z4yx/StepperMotorTester/PCB/stepper.pdf

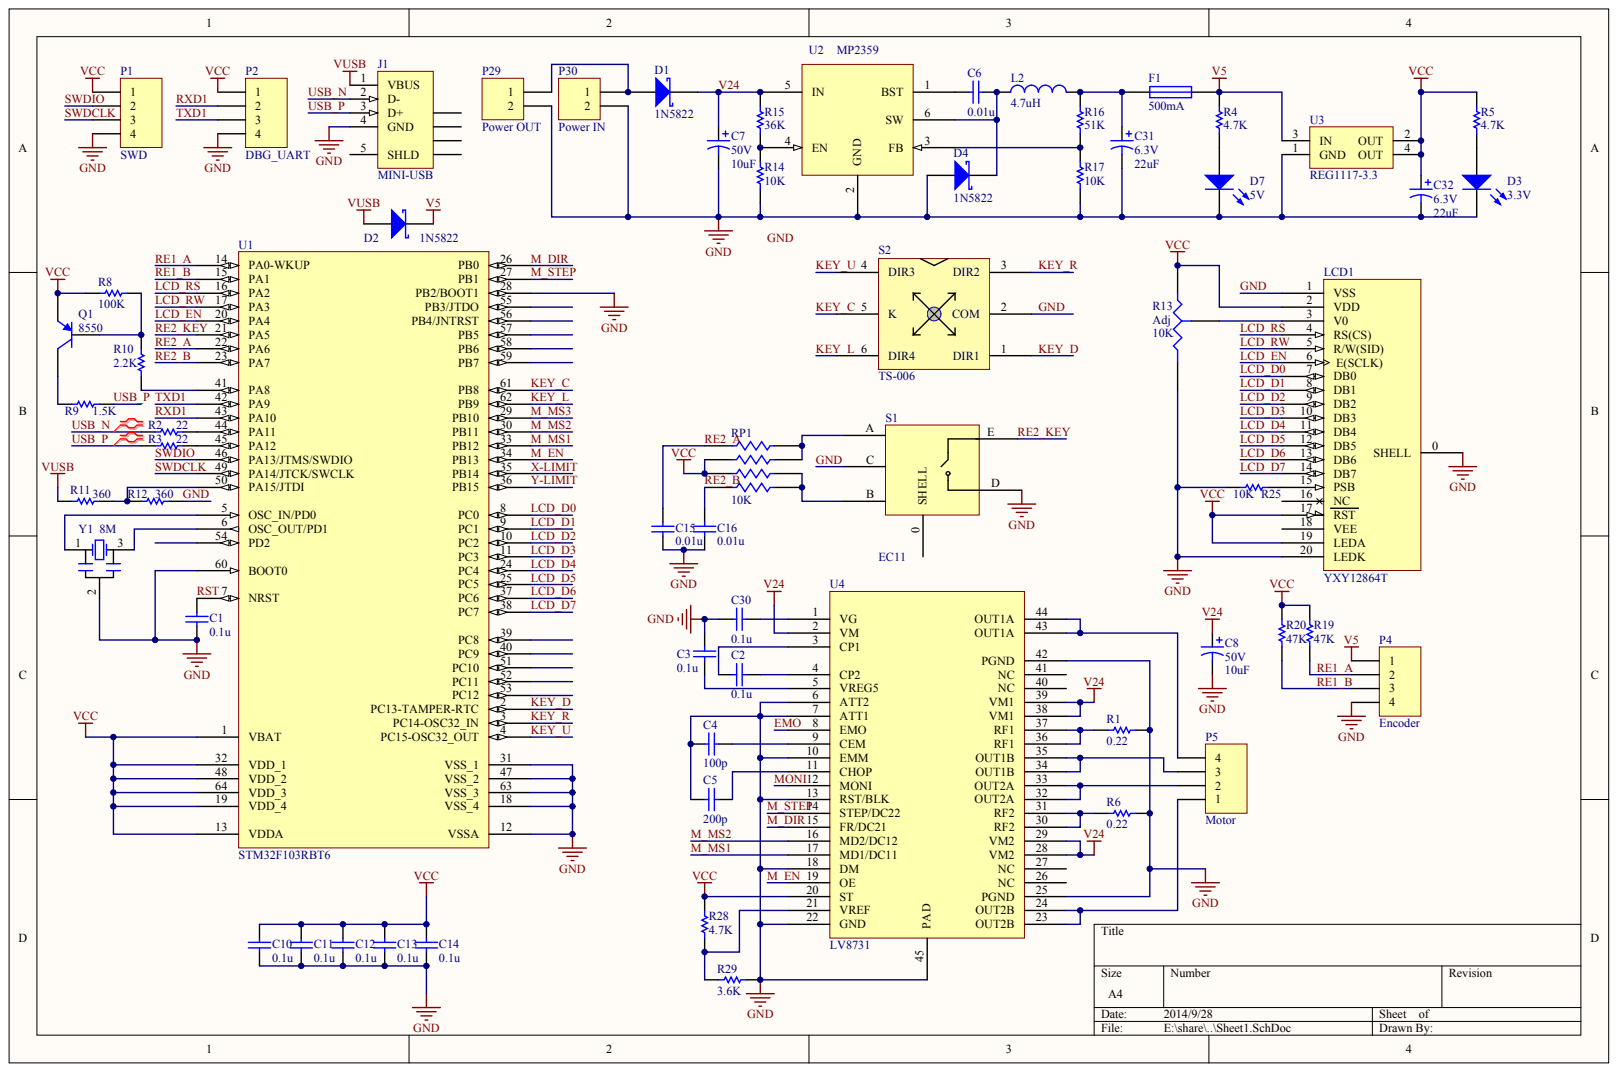
[picture p1: page 1]

ATT1 7

EMO | EMO 8

VDD_1 32
VDD_2 48
VDD_3 64
VDD_4 19

CHOP 11
MONI | MONI 12

VDDA 13

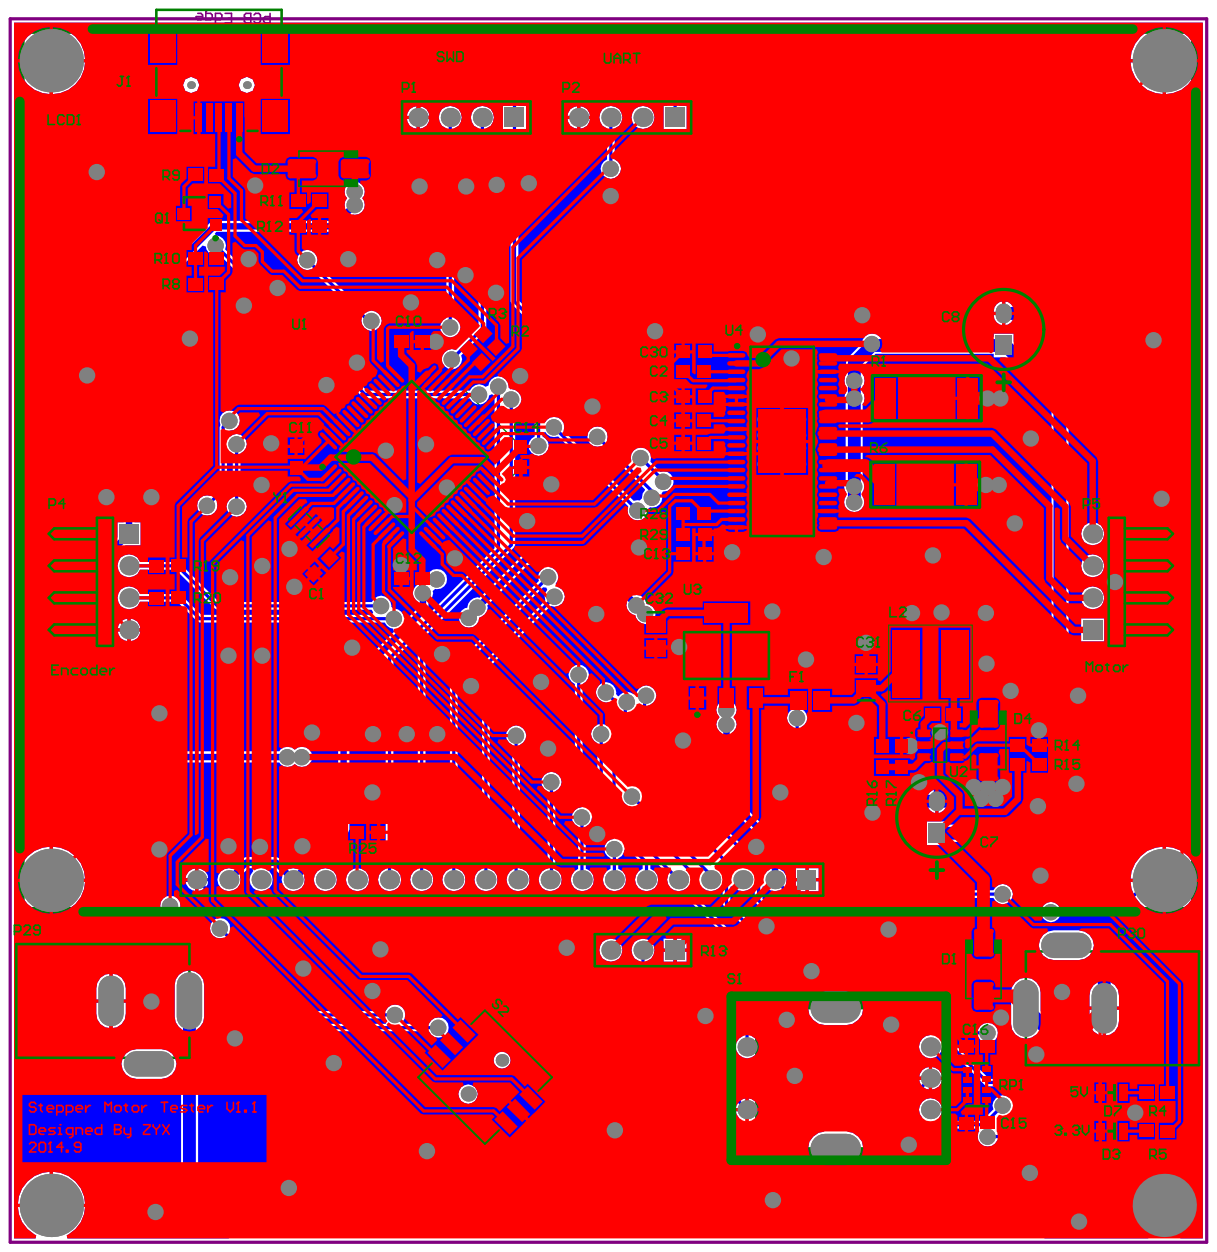
[picture p2: page 2]
