z4yx/StepperMotorTester/(list of files, drawings)

Other design files:
PCB/Mod-A4988.PcbLib
PCB/Mod-A4988.SchLib
PCB/PCB1.PcbDoc
PCB/Schlib1.SchLib
PCB/Sheet1.SchDoc
PCB/stepper.PrjPCB
