z4yx/StepperMotorTester/firmware/Project/chinese_gbk.h

#ifndef CHINESE_GBK__
#define CHINESE_GBK__

#define STR_MOTOR_DRIVE   " 电机驱动"
#define STR_MOTOR_MEASURE " 电机测量"

#define STR_FIXED_VELOCITY " 定转速"
#define STR_FIXED_FREQ     " 定频率"
#define STR_FIXED_STEPS    " 定步数"

#define STR_SET_VELOCITY  " 转速[%d]r/min"
#define STR_SET_FREQ      " 频率[%d]Hz"
#define STR_SET_MS        " 细分[1/%s]"
#define STR_SET_STEPS     " 步数[%d]"
#define STR_SHOW_VELOCITY " 转速 %dr/min"
#define STR_SHOW_ANGLE    " 角度 %3d°"

#define STR_START         "    [开始]"
#define STR_STOP          "    [停止]"
#define STR_RUN           "    [运行]"
#define STR_CLEAR         "    [清零]"

#endif
