z4yx/StepperMotorTester/firmware/Project/params.h

#ifndef PARAMS_H__
#define PARAMS_H__

#include "menu.h"

extern struct ItemNumberModel MotorVelocity;
extern struct ItemNumberModel MotorFreq;
extern struct ItemNumberModel MotorSteps;
extern struct ItemStringModel MotorMicroStep;

extern struct ItemNumberModel MeasureVelocity;
extern struct ItemNumberModel MeasureAngle;

#endif
