z4yx/StepperMotorTester/firmware/Project/keyboard.h

#ifndef __KEYBOARD_H
#define	__KEYBOARD_H

#include "common.h"

#define NUM_KEYS 5

enum { KEY_LEFT, KEY_RIGHT, KEY_UP, KEY_DOWN, KEY_CENTER };

enum { KEYEVENT_UP, KEYEVENT_DOWN, KEYEVENT_REPEAT};

void KeyBoard_Init(void);
bool KeyBoard_isPressed(uint8_t num);
void KeyBoard_EventHandler(uint8_t key, uint8_t type);

#endif /* __KEYBOARD_H */
