z4yx/StepperMotorTester/(commit log)

2014-09-24 motor driver
2014-09-24 change timer
2014-09-25 fix bug of microstep
    [motor.c, params.c]
2014-09-29 hardware V1.1
    [Mod-A4988.PcbLib, Mod-A4988.SchLib, PCB1.PcbDoc, Schlib1.SchLib, Sheet1.SchDoc, stepper.PrjPCB]
2014-09-29 stop tracking .PcbDoc.htm
2014-10-09 round up velocity
2014-10-09 fix display of angle
    [chinese_gbk.h]
2014-10-09 support for center button
2014-10-09 update schematic parameters
    [BOM.xlsx, Mod-A4988.PcbLib, Mod-A4988.SchLib, Schlib1.SchLib, Sheet1.SchDoc, stepper.PrjPCB]
2014-10-14 fix missing function in MDK
    [motor.c]
2014-10-14 using new compiler gcc-arm-embedded
